stancupatrick1/spitalul-virtual/watch/hardware/kicad/drc_report.txt

** Drc report for spitalul_virtual_watch.kicad_pcb **
** Created on 2026-10-27 00:28:51 **

** Found 0 DRC violations **

** Found 0 unconnected pads **

** Found 0 Footprint errors **

** End of Report **
