stancupatrick1/spitalul-virtual/band/docs/img/band_back.png

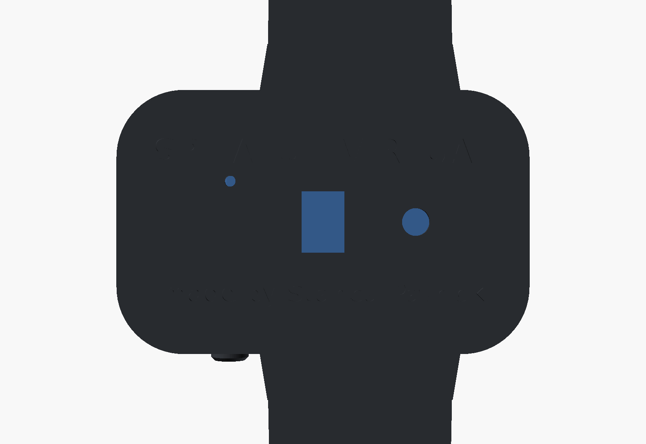
band/docs/img/band_back.png
