stancupatrick1/spitalul-virtual/band/docs/img/band_inside.png

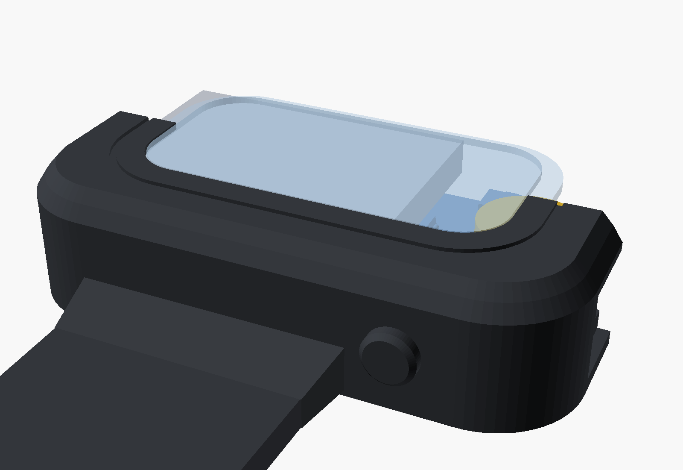
band/docs/img/band_inside.png
