stancupatrick1/spitalul-virtual/site/olimpiada.jpg

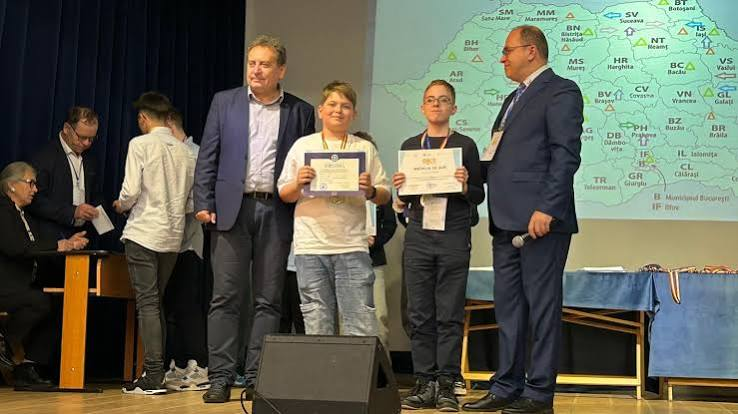
site/olimpiada.jpg
