stancupatrick1/spitalul-virtual/watch/docs/img/watch_bottom.png

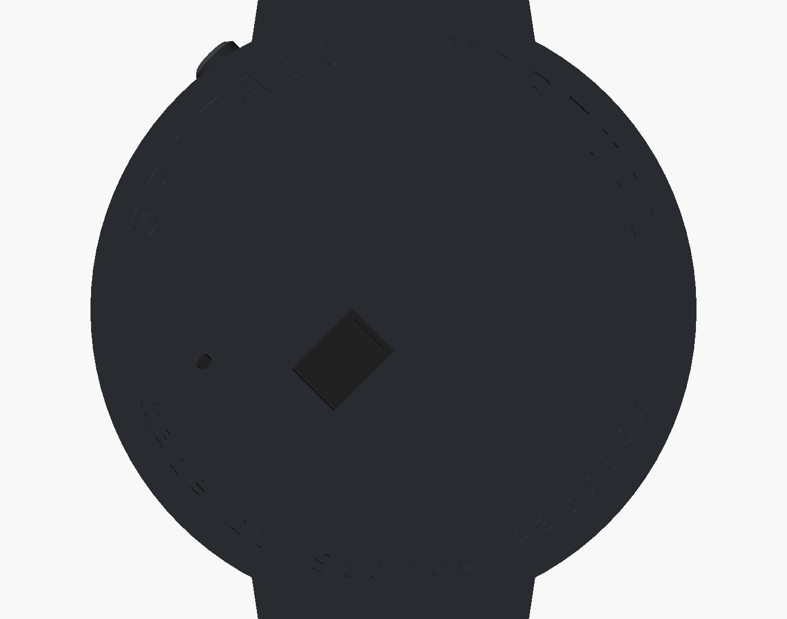
watch/docs/img/watch_bottom.png
