stancupatrick1/spitalul-virtual/band/hardware/jlcpcb/spitalul_virtual_band_BOM.csv

Comment | Designator | Footprint | LCSC Part #
1uF | C1,C8,C9 | C_0402_1005Metric | C52923
100nF | C3,C10,C12,C13,C15,C16 | C_0402_1005Metric | C1525
10uF | C2,C4,C5,C6,C7,C11,C14 | C_0603_1608Metric | C19702
1N4148WS | D1 | D_SOD-323 | C2128
Red LED | D2 | LED_0603_1608Metric | C2286
Green LED | D3 | LED_0603_1608Metric | C72043
USB-C 16P | J1 | USB_C_Receptacle_HRO_TYPE-C-31-M-12 | C165948
AO3400A | Q1 | SOT-23 | C20917
10k | R1,R10,R11,R12 | R_0402_1005Metric | C25744
100k | R8,R9,R13 | R_0402_1005Metric | C25741
1k | R5,R14 | R_0402_1005Metric | C11702
5.1k | R2,R3 | R_0402_1005Metric | C25905
4.7k | R4,R6,R7 | R_0402_1005Metric | C25900
EVQP7C01P | SW1 | SW_SPST_EVQP7C | C388883
ESP32-C3-WROOM-02-N4 | U1 | ESP32-C3-WROOM-02 | C2934560
MAX30102EFD+T | U2 | Maxim_OLGA-14_3.3x5.6mm_P0.8mm | C6454833
LIS3DHTR | U3 | LGA-16_3x3mm_P0.5mm_LayoutBorder3x5y | C15134
MCP73831T-2ACI/OT | U4 | SOT-23-5 | C424093
ME6211C33M5G-N | U5 | SOT-23-5 | C82942
XC6206P182MR | U6 | SOT-23 | C347373
TMP117AIDRVR | U7 | WSON-6-1EP_2x2mm_P0.65mm_EP1x1.6mm | C699536
