stancupatrick1/spitalul-virtual/band/mechanical/pcb_assembled.step

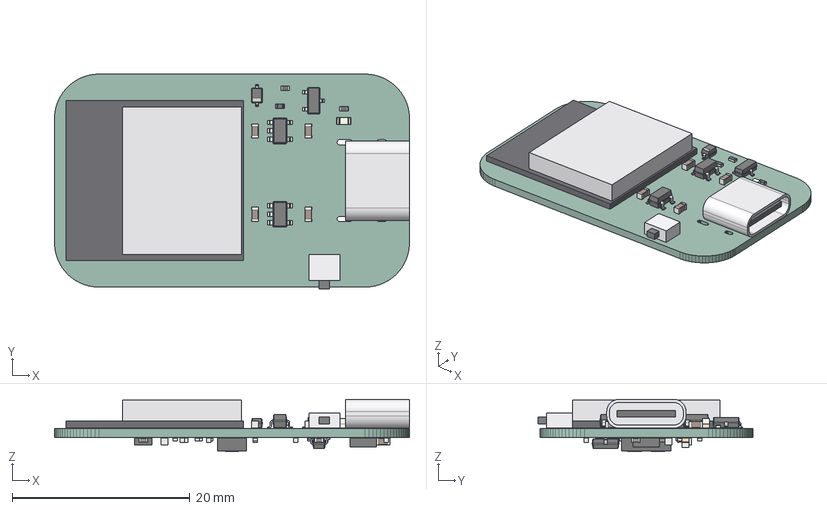
[picture p14: CAD file, 2026-11-08]
band/mechanical/pcb_assembled.step
40.0 x 24.2 x 5.91 mm
LED_0603_1608Metric x 2
SOT_23_5 x 2
R_0402_1005Metric x 14
D_SOD_323
C_0603_1608Metric x 7
6a490142-d207-11f1-81ee-f1fb133c2f88
6a516062-d207-11f1-81ee-f1fb133c2f88
SOT_23 x 2
6a4750ae-d207-11f1-81ee-f1fb133c2f88
C_0402_1005Metric x 9
WSON_6_1EP_2x2mm_P065mm_EP1x16mm
6a4ff8b2-d207-11f1-81ee-f1fb133c2f88
LGA_16_3x3mm_P05mm_LayoutBorder3x5y
spitalul_virtual_band PCB
