stancupatrick1/spitalul-virtual/watch/mechanical/pcb_assembled.step

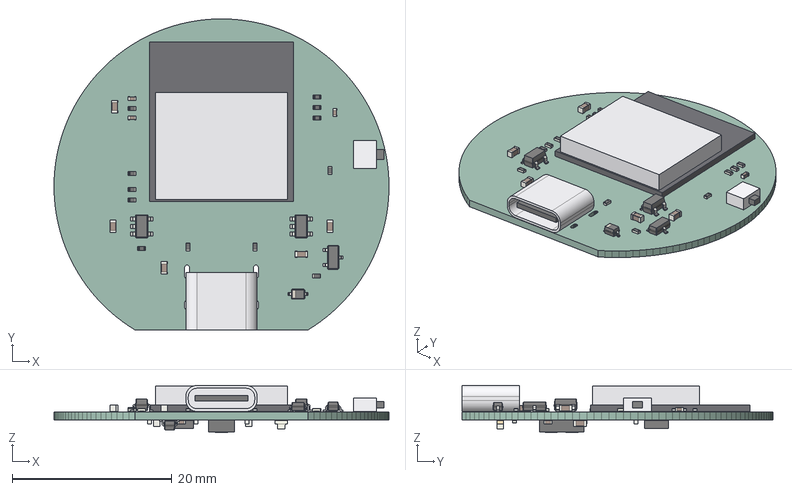
[picture p15: CAD file, 2026-11-08]
watch/mechanical/pcb_assembled.step
42.0 x 39.0 x 5.91 mm
R_0402_1005Metric x 13
C_0603_1608Metric x 7
D_SOD_323
C_0402_1005Metric x 8
7226c212-d18c-11f1-bdcd-9d31cddf0451
SOT_23_5 x 2
7233ba26-d18c-11f1-bdcd-9d31cddf0451
SOT_23 x 2
72246710-d18c-11f1-bdcd-9d31cddf0451
72318ba2-d18c-11f1-bdcd-9d31cddf0451
LED_0603_1608Metric
LGA_16_3x3mm_P05mm_LayoutBorder3x5y
spitalul_virtual_watch PCB
