stancupatrick1/spitalul-virtual/band/mechanical/stl/band_top_cap.stl

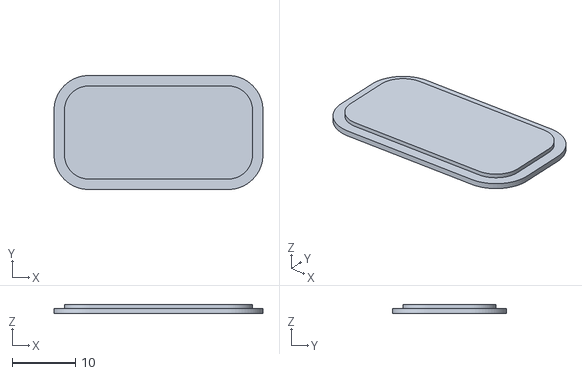
[picture p16: CAD file, 2026-11-08]
band/mechanical/stl/band_top_cap.stl
33.0 x 18.0 x 1.39
