stancupatrick1/spitalul-virtual/band/mechanical/stl/mold/mold_core.stl

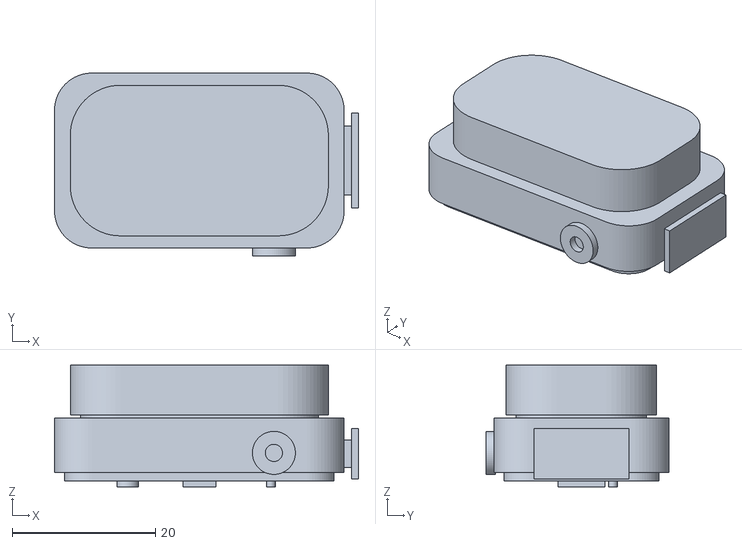
[picture p17: CAD file, 2026-11-08]
band/mechanical/stl/mold/mold_core.stl
42.4 x 25.5 x 17.0
