stancupatrick1/spitalul-virtual/watch/mechanical/stl/mold/mold_core.stl

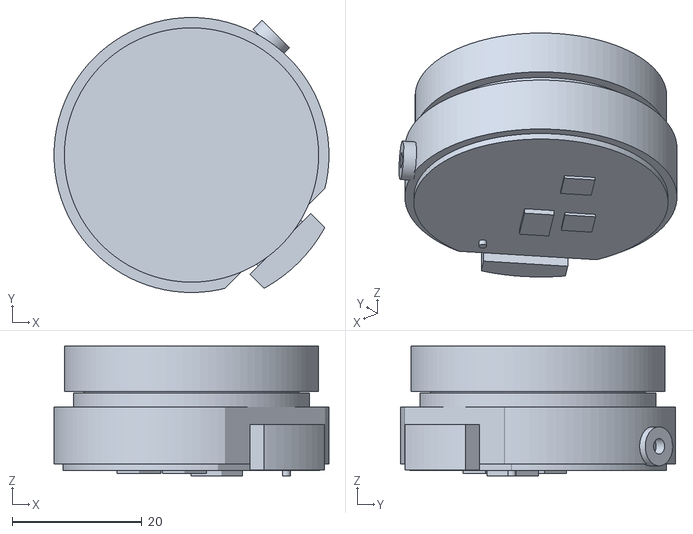
[picture p18: CAD file, 2026-11-08]
watch/mechanical/stl/mold/mold_core.stl
42.4 x 42.4 x 20.0
