stancupatrick1/spitalul-virtual/watch/mechanical/stl/strap_keeper_loop.stl

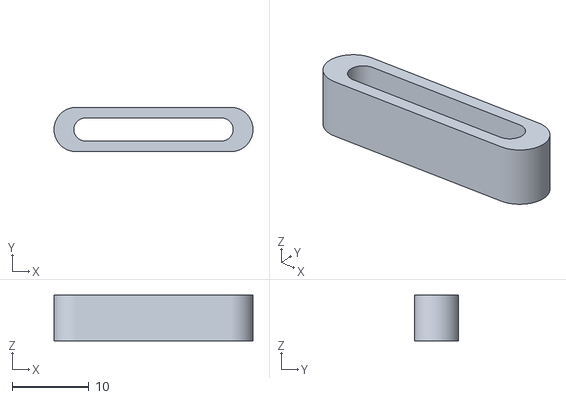
[picture p19: CAD file, 2026-11-08]
watch/mechanical/stl/strap_keeper_loop.stl
26.0 x 5.80 x 6.00
