stancupatrick1/spitalul-virtual/band/mechanical/stl/mold/mold_bottom.stl

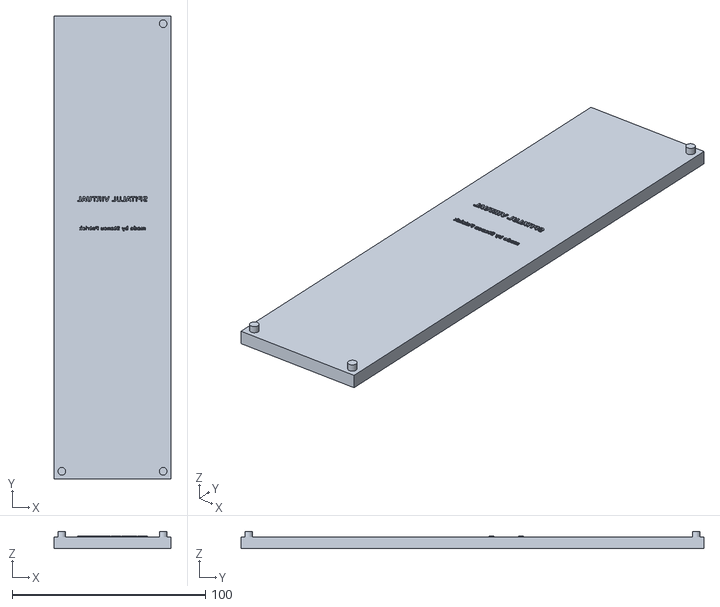
[picture p20: CAD file, 2026-11-08]
band/mechanical/stl/mold/mold_bottom.stl
60.4 x 239.4 x 9.00
