stancupatrick1/spitalul-virtual/watch/mechanical/stl/case_silicone_with_straps.stl

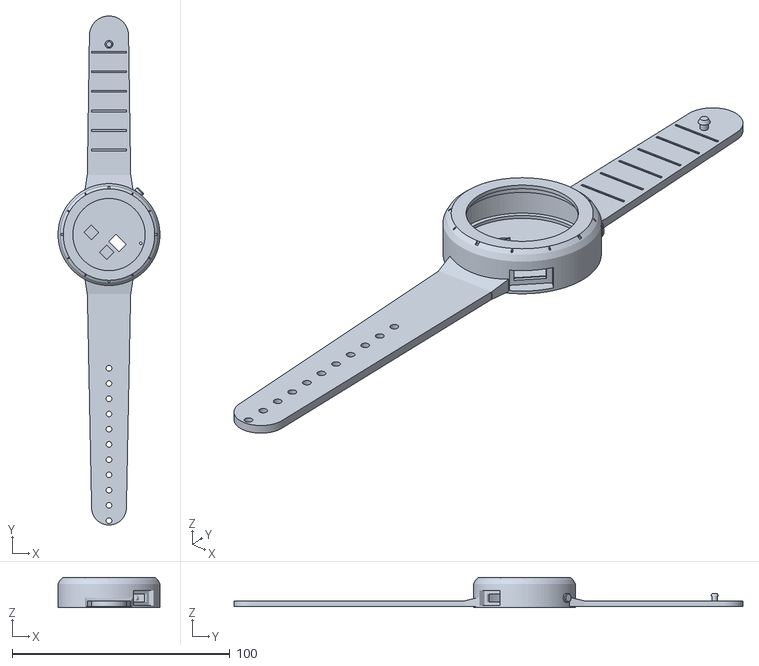
[picture p21: CAD file, 2026-11-08]
watch/mechanical/stl/case_silicone_with_straps.stl
46.8 x 233.8 x 14.0
