stancupatrick1/spitalul-virtual/watch/mechanical/stl/mold/mold_top.stl

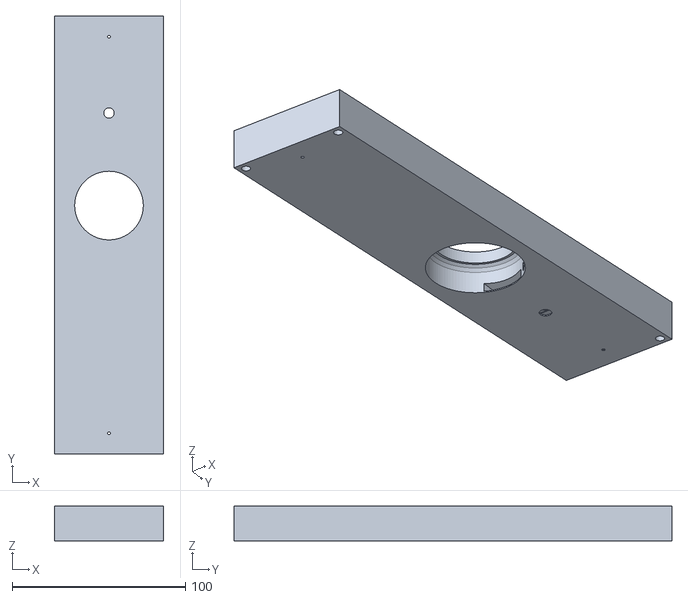
[picture p22: CAD file, 2026-11-08]
watch/mechanical/stl/mold/mold_top.stl
62.8 x 252.8 x 20.0
