stancupatrick1/spitalul-virtual/band/mechanical/stl/band_silicone_with_straps.stl

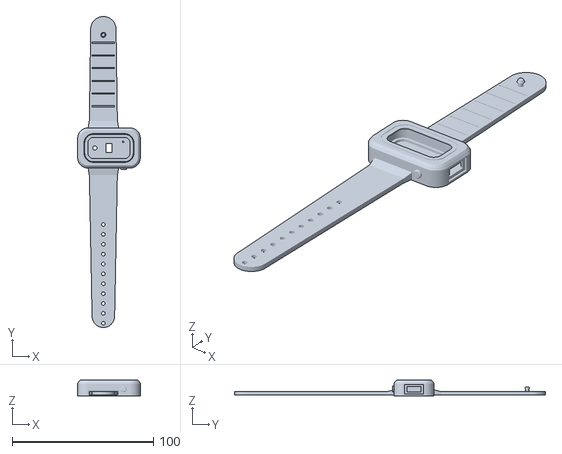
[picture p23: CAD file, 2026-11-08]
band/mechanical/stl/band_silicone_with_straps.stl
44.4 x 220.4 x 11.0
