stancupatrick1/spitalul-virtual/band/mechanical/stl/mold/mold_top.stl

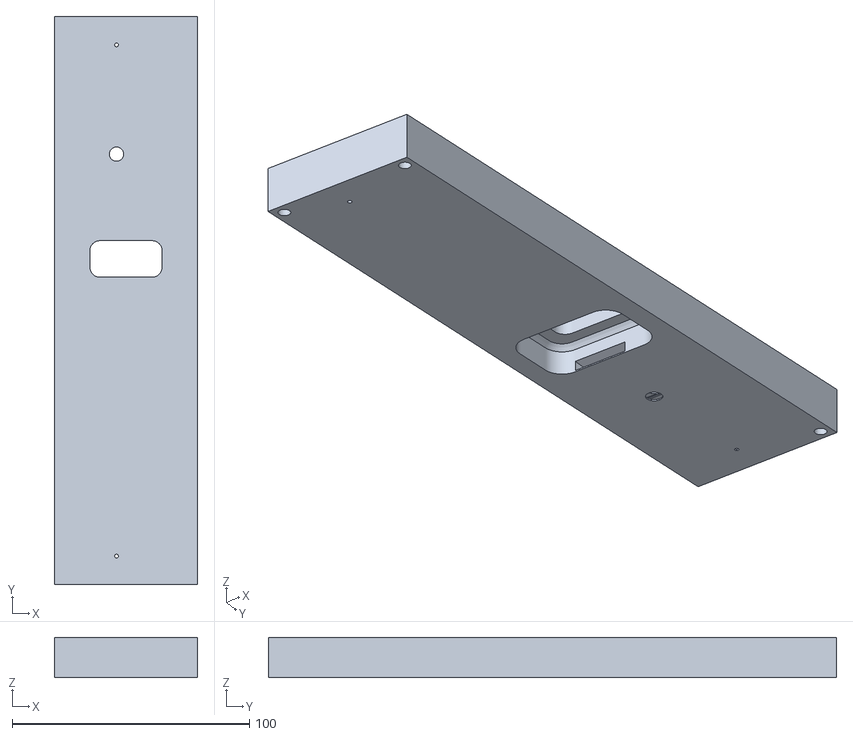
[picture p24: CAD file, 2026-11-08]
band/mechanical/stl/mold/mold_top.stl
60.4 x 239.4 x 17.0
