stancupatrick1/spitalul-virtual/watch/mechanical/stl/mold/mold_bottom.stl

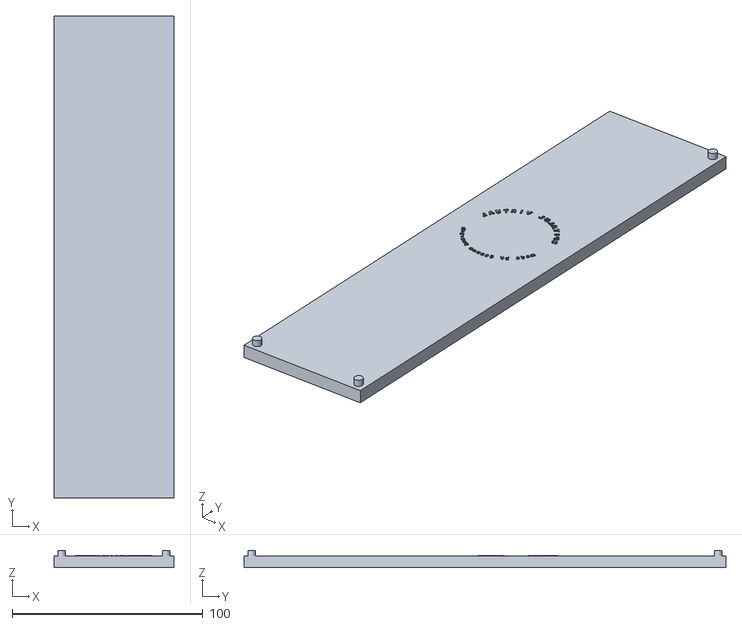
[picture p25: CAD file, 2026-11-08]
watch/mechanical/stl/mold/mold_bottom.stl
62.8 x 252.8 x 9.00
