stancupatrick1/spitalul-virtual/(list of files, cad)

Other CAD files:
band/mechanical/stl/band_strap_keeper.stl
band/mechanical/stl/pcb_assembled.stl
watch/mechanical/stl/pcb_assembled.stl
