stancupatrick1/spitalul-virtual/band/docs/schematic.pdf

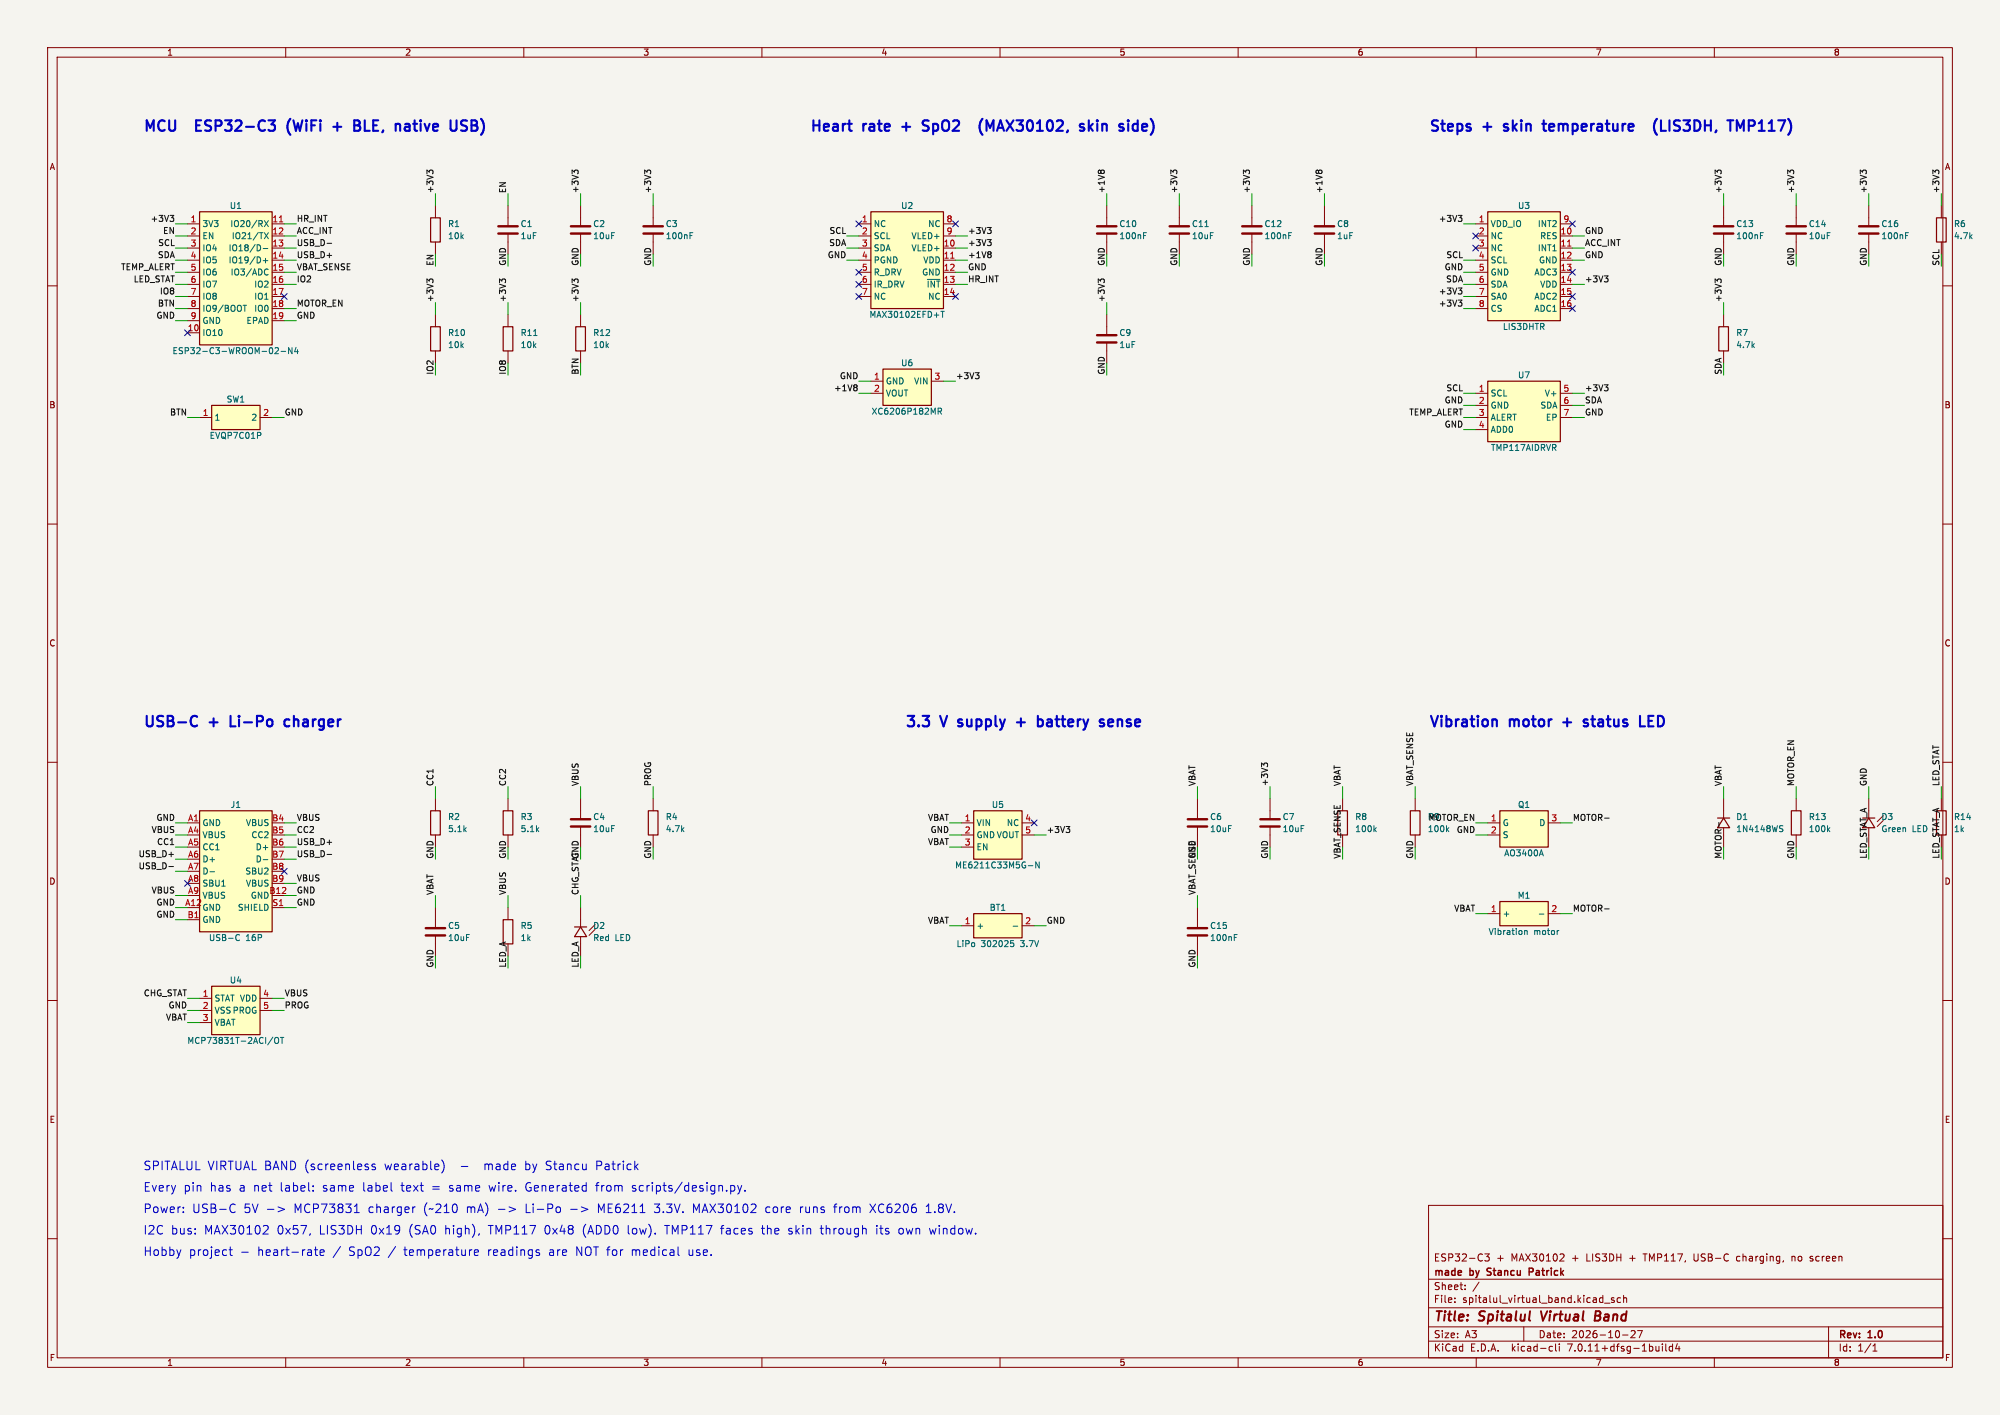
[picture p27: page 1]

INT1 11 GND 12 ADC3 13 VDD 14 ADC2 15 ADC1 16 NC 2 NC 3 SCL 4 GND 5 SDA 6 SA0 7 CS 8

Every pin has a net label: same label text = same wire. Generated from scripts/design.py.
I2C bus: MAX30102 0x57, LIS3DH 0x19 (SA0 high), TMP117 0x48 (ADD0 low). TMP117 faces the skin through its own window.

Id: 1/1 Title: Spitalul Virtual Band
