stancupatrick1/spitalul-virtual/watch/docs/schematic.pdf

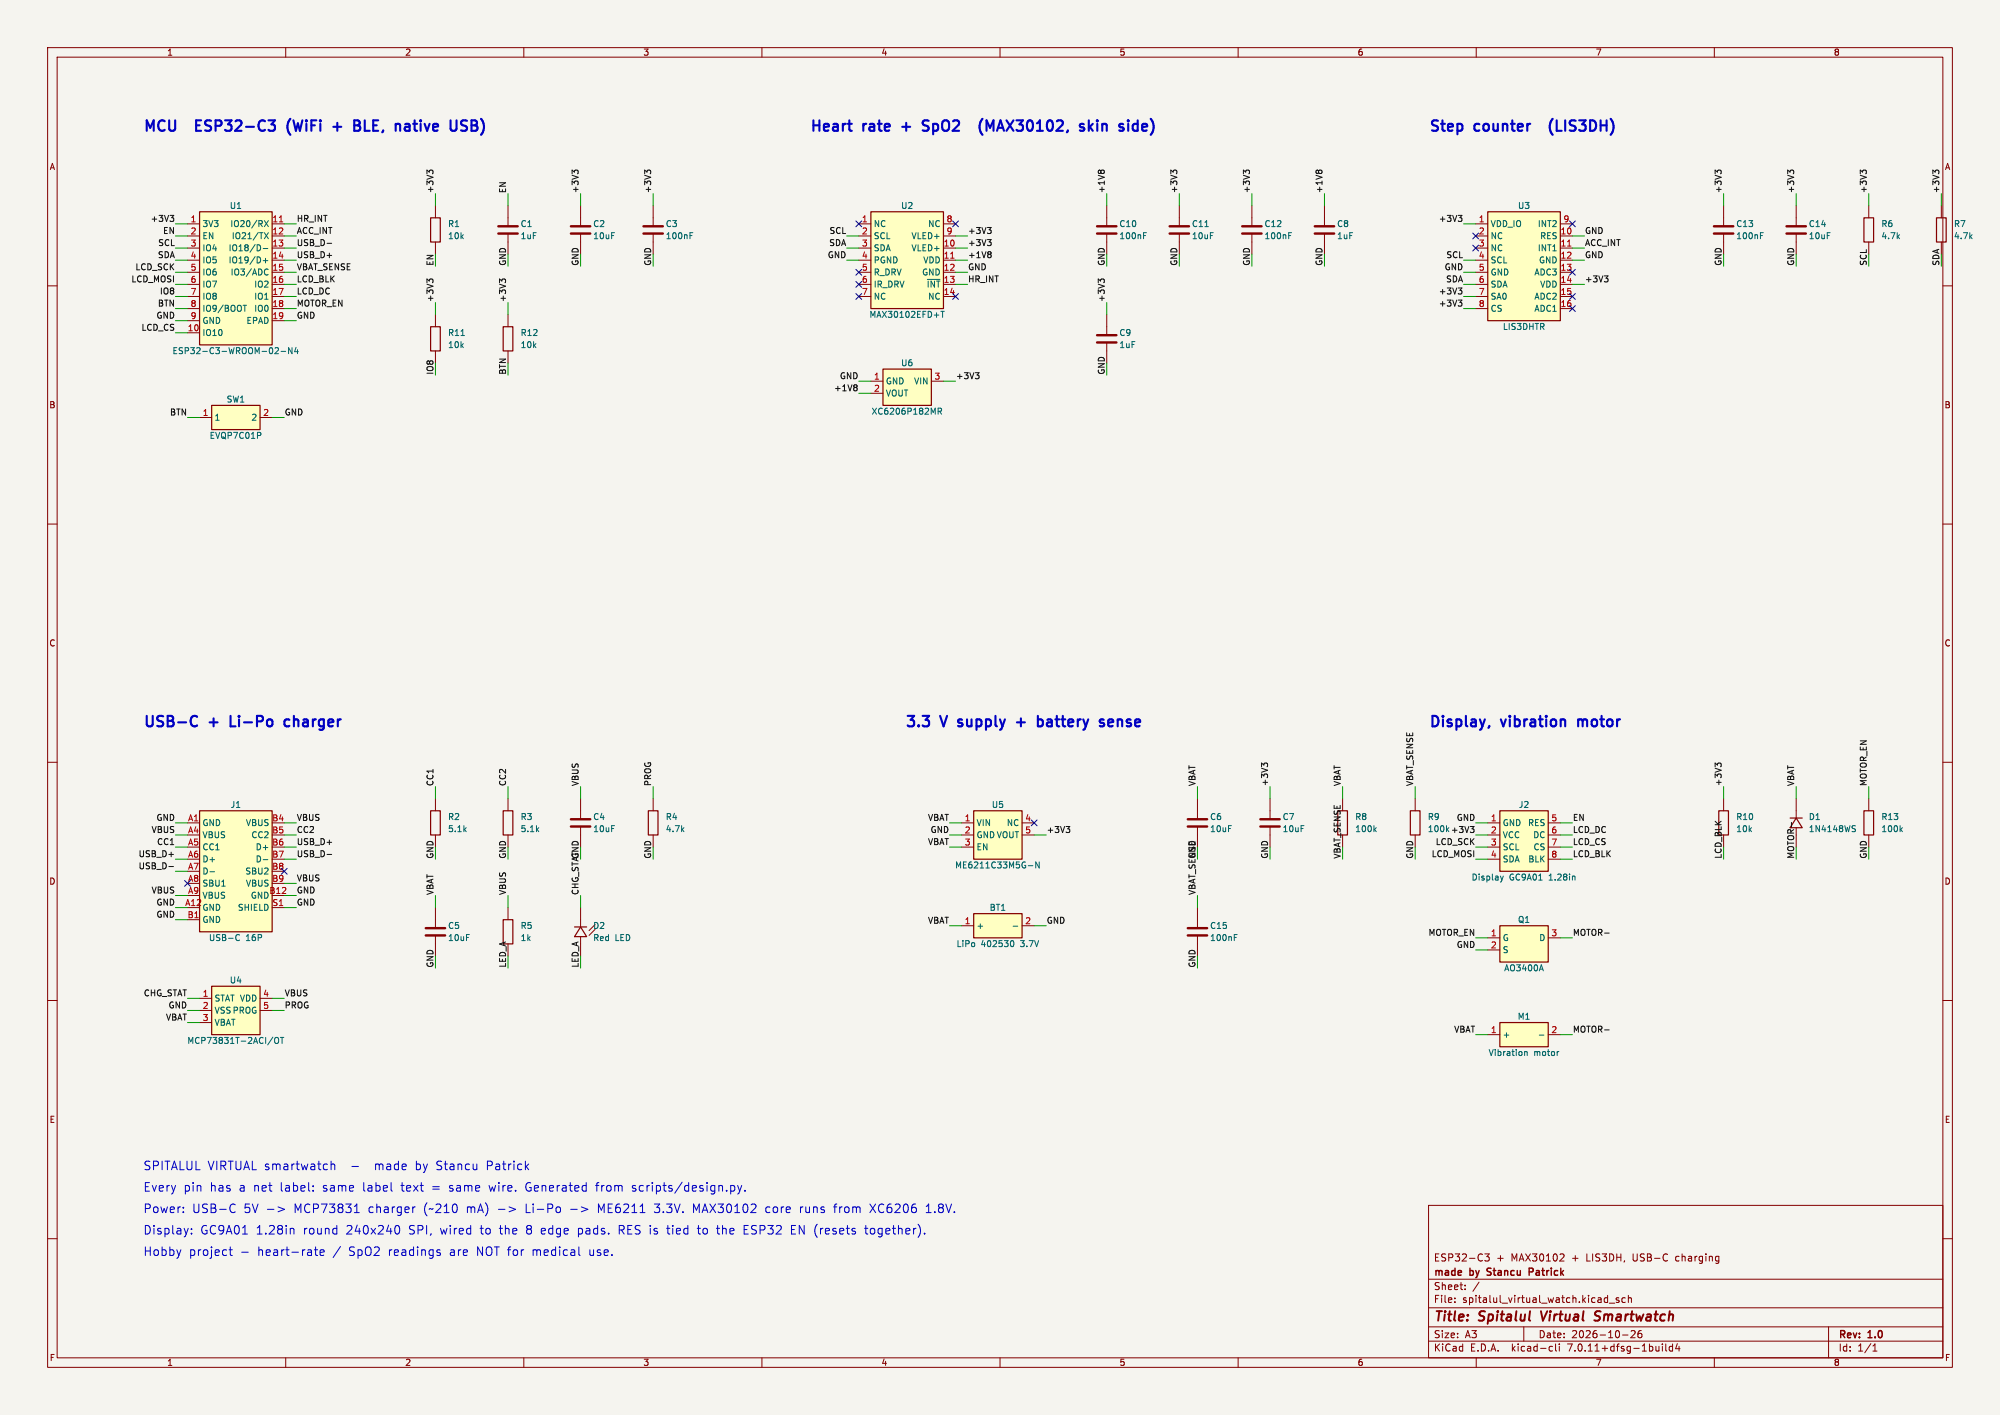
[picture p28: page 1]

VBAT VBAT PROG VBUS

Every pin has a net label: same label text = same wire. Generated from scripts/design.py.

Id: 1/1 Title: Spitalul Virtual Smartwatch
