stancupatrick1/spitalul-virtual/band/docs/pcb_bottom_layer.pdf

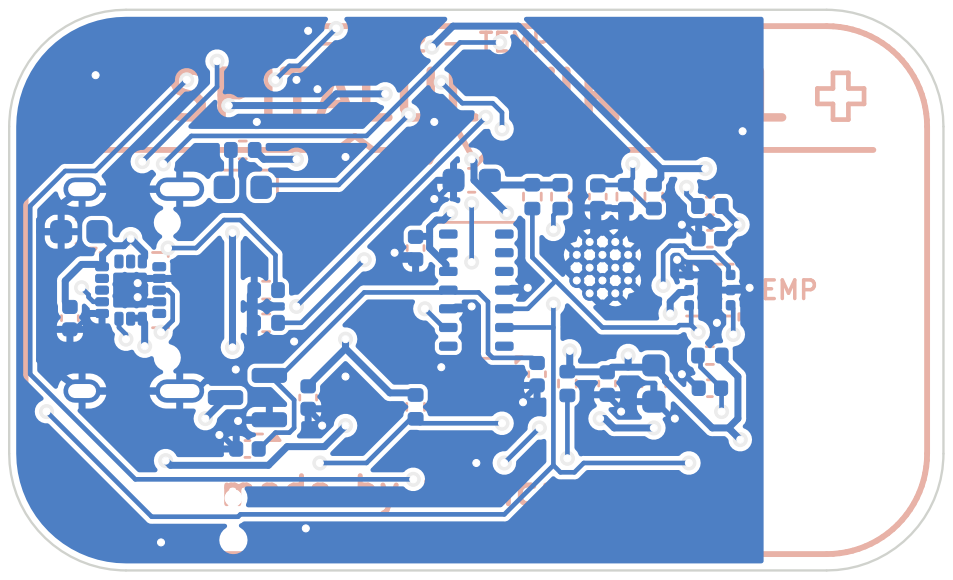
[picture p29: page 1]

TEMP HR - SpO2 - TEMP - STEPS
