stancupatrick1/spitalul-virtual/band/docs/pcb_top_layer.pdf

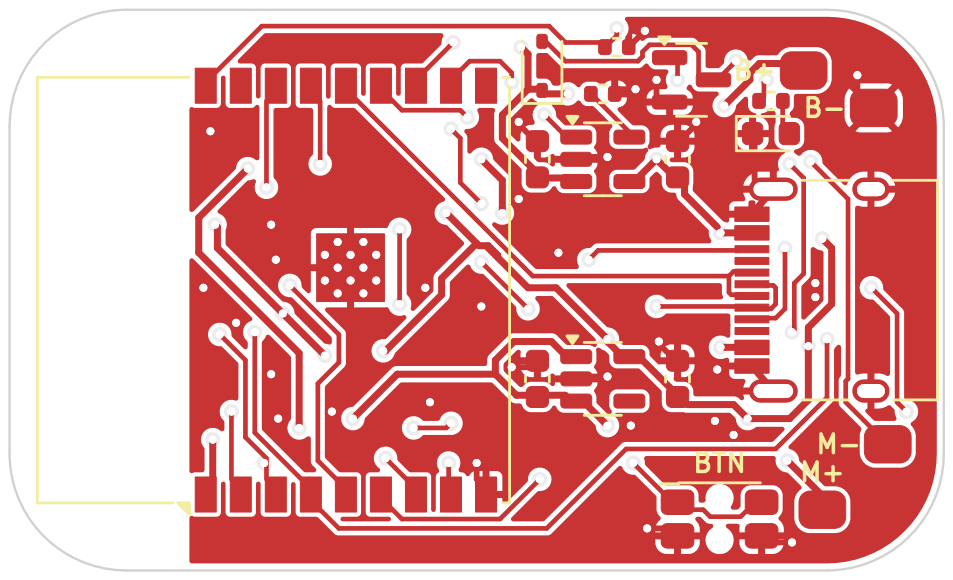
[picture p30: page 1]
