stancupatrick1/spitalul-virtual/watch/docs/pcb_bottom_layer.pdf

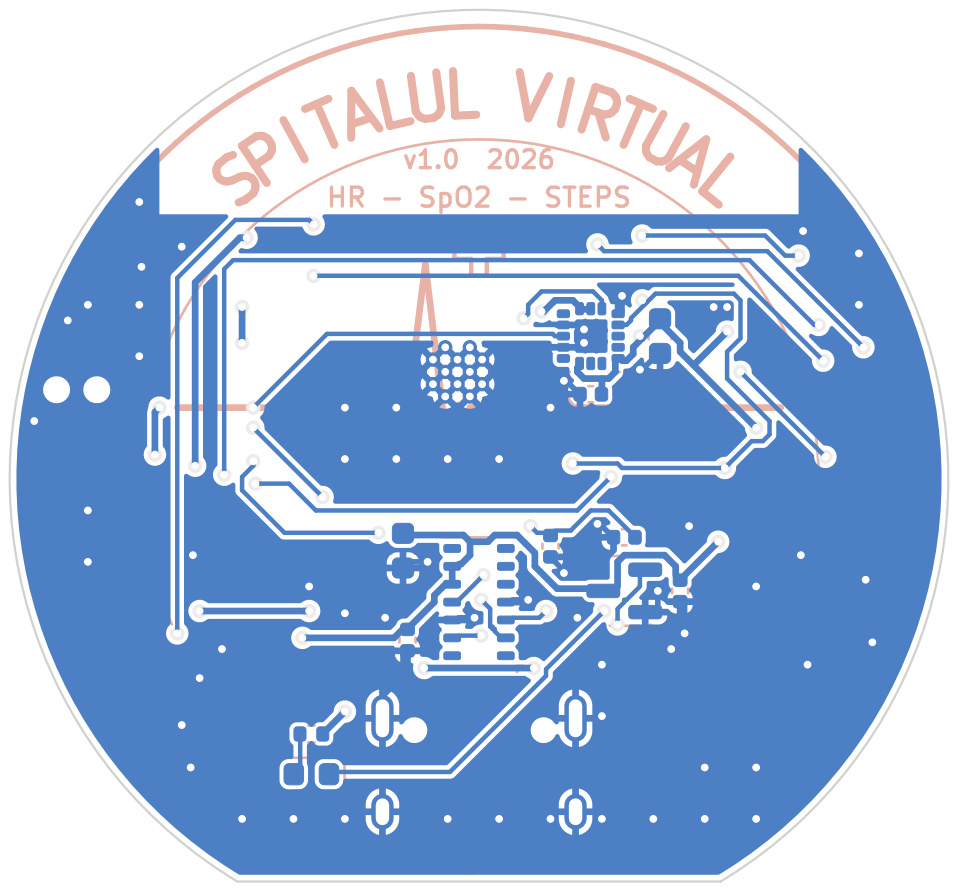
[picture p31: page 1]
