stancupatrick1/spitalul-virtual/watch/docs/pcb_top_layer.pdf

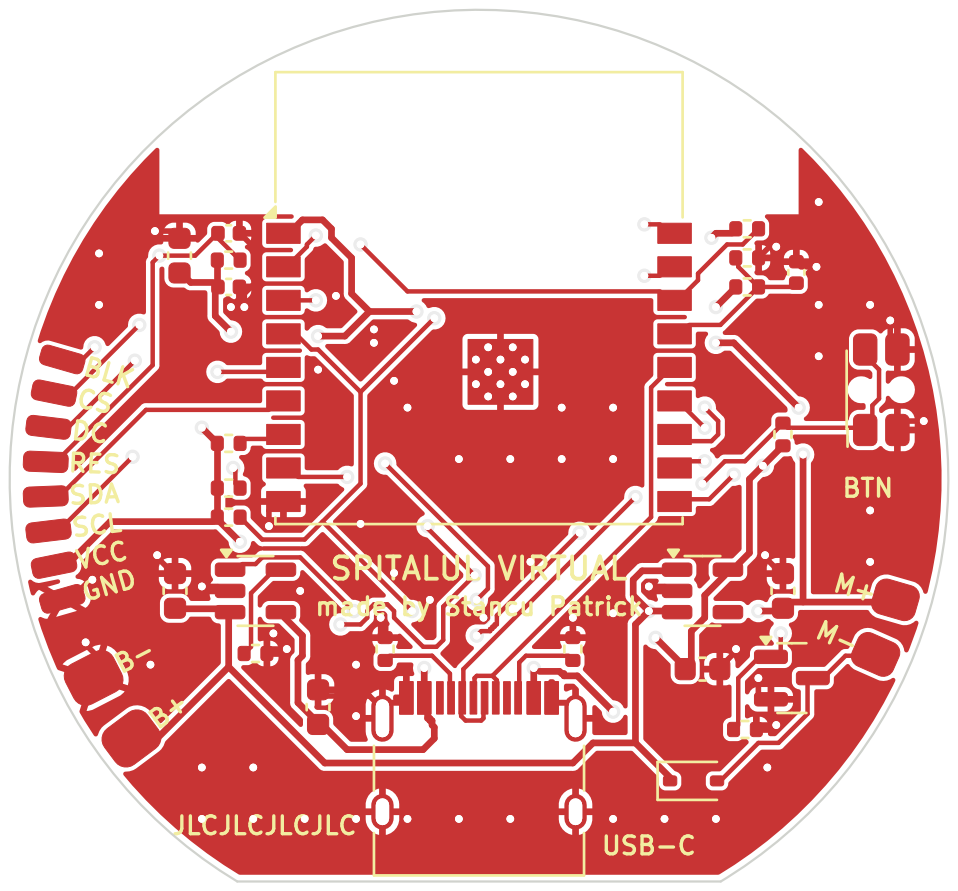
[picture p32: page 1]
