stancupatrick1/spitalul-virtual/band/hardware/kicad/spitalul_virtual_band.kicad_pcb

## KiCad design band/hardware/kicad/spitalul_virtual_band.kicad_pcb (2026-11-08)

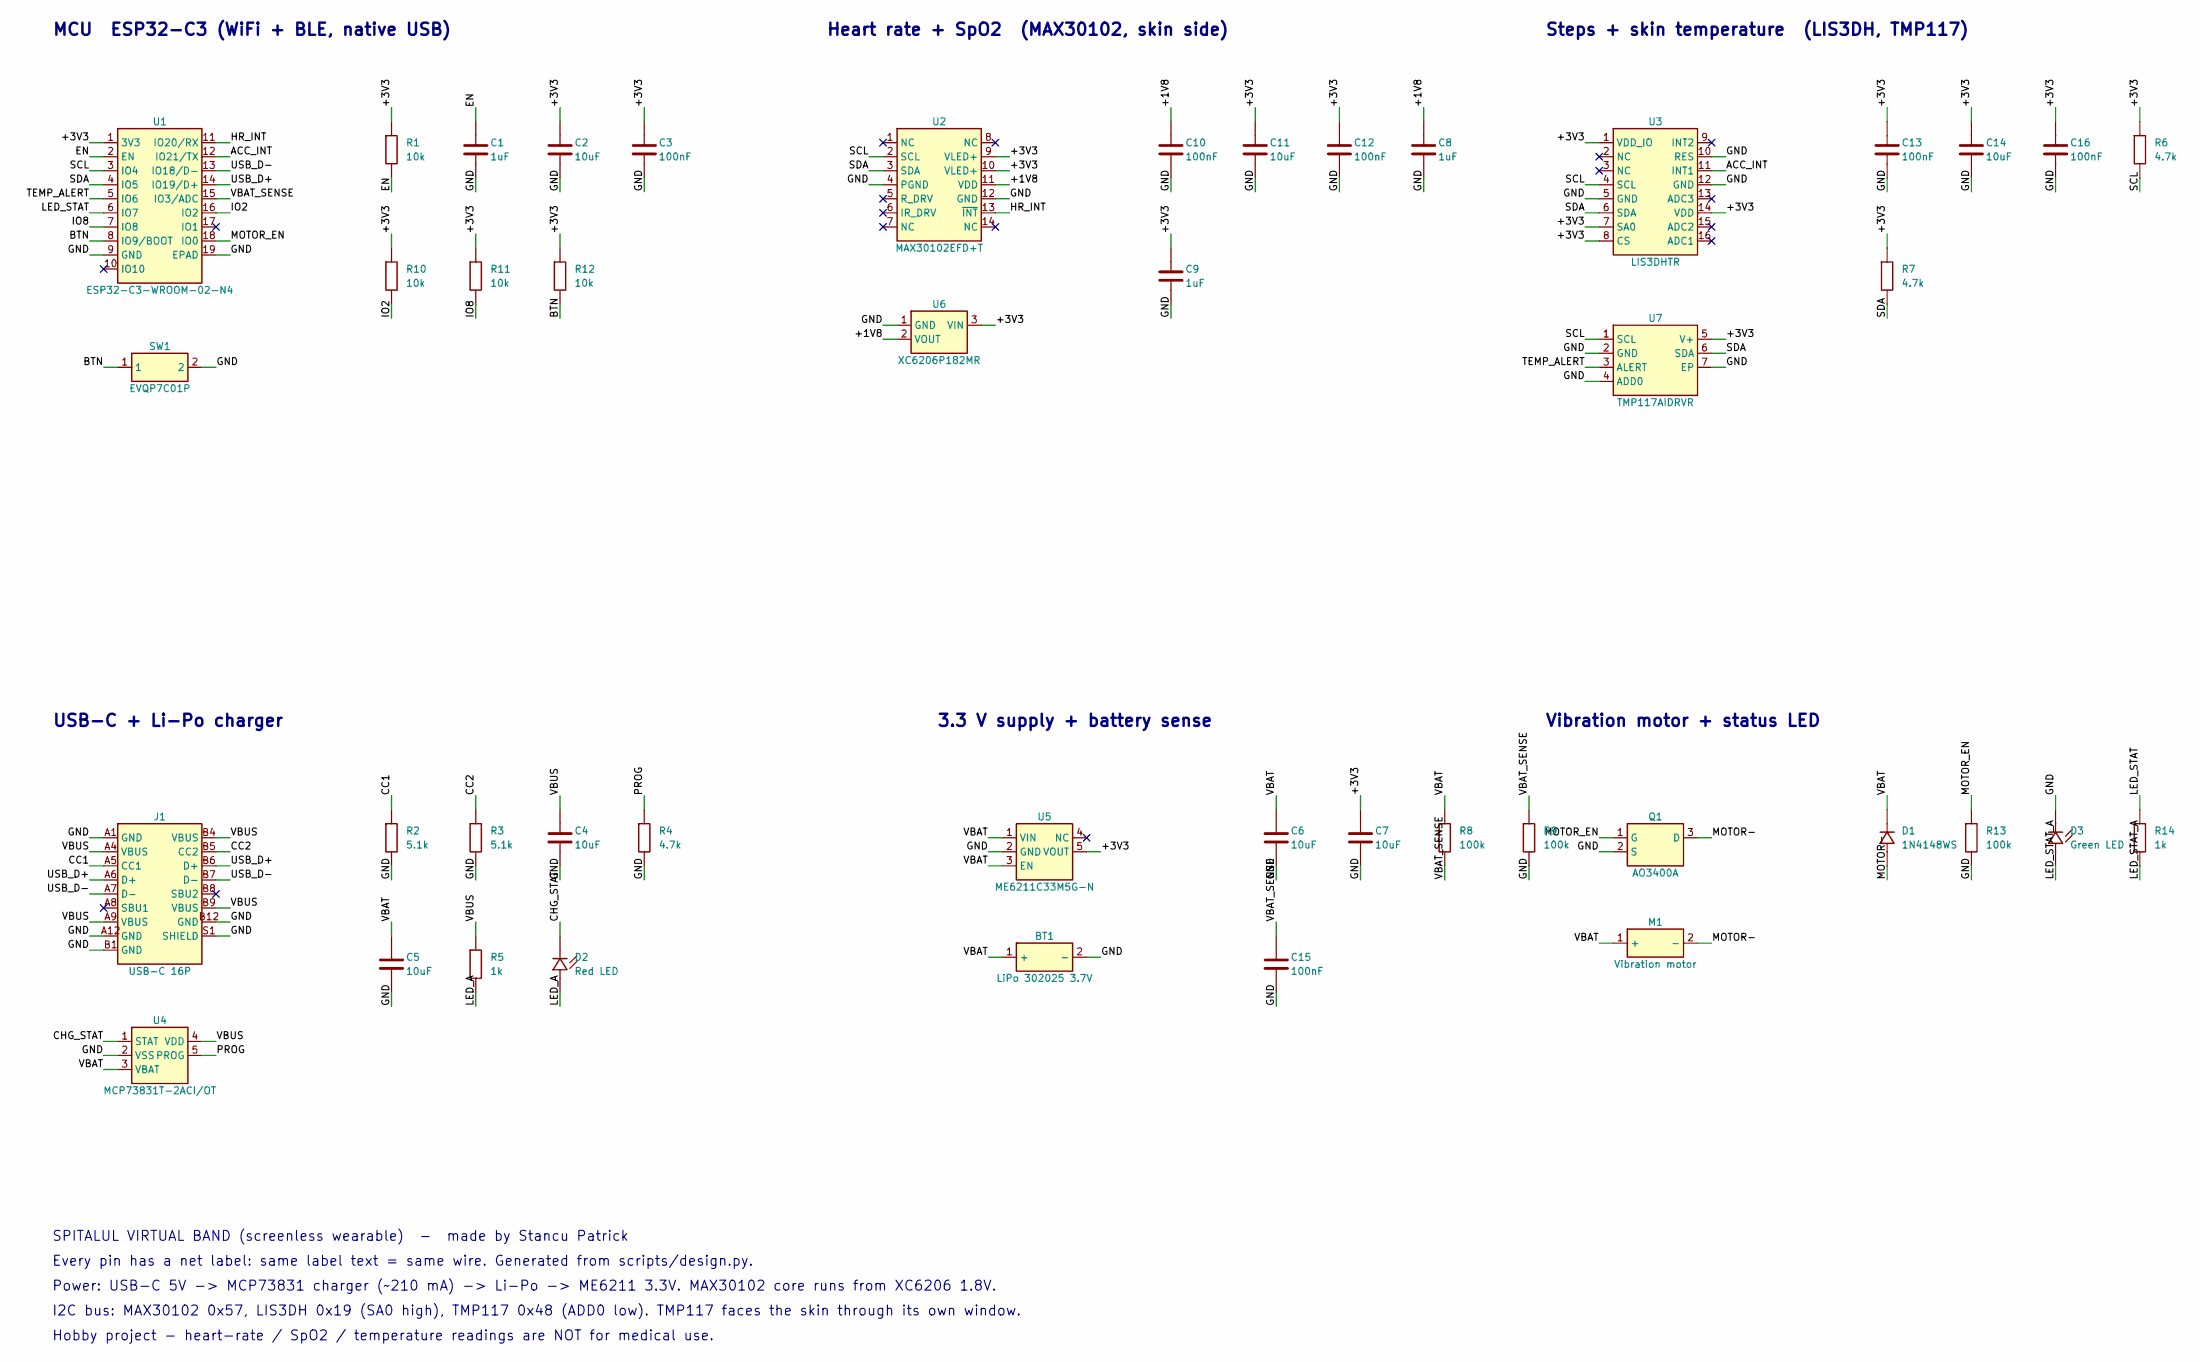
[picture p33: schematic spitalul_virtual_band.kicad_sch, Spitalul Virtual Band]

Parts:
BT1: LiPo 302025 3.7V; BatteryPads
C1, C8, C9: 1uF; C_0402_1005Metric; LCSC C52923
C2, C4, C5, C6, C7, C11, C14: 10uF; C_0603_1608Metric; LCSC C19702
C3, C10, C12, C13, C15, C16: 100nF; C_0402_1005Metric; LCSC C1525
D1: 1N4148WS; D_SOD-323; LCSC C2128
D2: Red LED; LED_0603_1608Metric; LCSC C2286
D3: Green LED; LED_0603_1608Metric; LCSC C72043
J1: USB-C 16P; USB_C_Receptacle_HRO_TYPE-C-31-M-12; LCSC C165948
M1: Vibration motor; MotorPads
Q1: AO3400A; SOT-23; LCSC C20917
R1, R10, R11, R12: 10k; R_0402_1005Metric; LCSC C25744
R2, R3: 5.1k; R_0402_1005Metric; LCSC C25905
R4, R6, R7: 4.7k; R_0402_1005Metric; LCSC C25900
R5, R14: 1k; R_0402_1005Metric; LCSC C11702
R8, R9, R13: 100k; R_0402_1005Metric; LCSC C25741
SW1: EVQP7C01P; SW_SPST_EVQP7C; LCSC C388883
U1: ESP32-C3-WROOM-02-N4; ESP32-C3-WROOM-02; LCSC C2934560
U2: MAX30102EFD+T; Maxim_OLGA-14_3.3x5.6mm_P0.8mm; LCSC C6454833
U3: LIS3DHTR; LGA-16_3x3mm_P0.5mm_LayoutBorder3x5y; LCSC C15134
U4: MCP73831T-2ACI/OT; SOT-23-5; LCSC C424093
U5: ME6211C33M5G-N; SOT-23-5; LCSC C82942
U6: XC6206P182MR; SOT-23; LCSC C347373
U7: TMP117AIDRVR; WSON-6-1EP_2x2mm_P0.65mm_EP1x1.6mm; LCSC C699536

Connections:
+1V8: C8.1, C10.1, U2.11 (VDD), U6.2 (VOUT)
+3V3: C2.1, C3.1, C7.1, C9.1, C11.1, C12.1, C13.1, C14.1, C16.1, R1.1, R6.1, R7.1, R10.1, R11.1, R12.1, U1.1 (3V3), U2.9 (VLED+), U2.10 (VLED+), U3.1 (VDD_IO), U3.7 (SA0), U3.8 (CS), U3.14 (VDD), U5.5 (VOUT), U6.3 (VIN), U7.5 (V+)
ACC_INT: U1.12 (IO21/TX), U3.11 (INT1)
BTN: R12.2, SW1.1, U1.8 (IO9/BOOT)
CC1: J1.A5 (CC1), R2.1
CC2: J1.B5 (CC2), R3.1
CHG_STAT: D2.1, U4.1 (STAT)
EN: C1.1, R1.2, U1.2 (EN)
GND: BT1.2 (-), C1.2, C2.2, C3.2, C4.2, C5.2, C6.2, C7.2, C8.2, C9.2, C10.2, C11.2, C12.2, C13.2, C14.2, C15.2, C16.2, D3.1, J1.A1 (GND), J1.A12 (GND), J1.B1 (GND), J1.B12 (GND), J1.S1 (SHIELD), Q1.2 (S), R2.2, R3.2, R4.2, R9.2, R13.2, SW1.2, U1.9 (GND), U1.19 (EPAD), U2.4 (PGND), U2.12 (GND), U3.5 (GND), U3.10 (RES), U3.12 (GND), U4.2 (VSS), U5.2 (GND), U6.1 (GND), U7.2 (GND), U7.4 (ADD0), U7.7 (EP)
HR_INT: U1.11 (IO20/RX), U2.13 (~INT)
IO2: R10.2, U1.16 (IO2)
IO8: R11.2, U1.7 (IO8)
LED_A: D2.2, R5.2
LED_STAT: R14.1, U1.6 (IO7)
LED_STAT_A: D3.2, R14.2
MOTOR-: D1.2, M1.2 (-), Q1.3 (D)
MOTOR_EN: Q1.1 (G), R13.1, U1.18 (IO0)
PROG: R4.1, U4.5 (PROG)
SCL: R6.2, U1.3 (IO4), U2.2 (SCL), U3.4 (SCL), U7.1 (SCL)
SDA: R7.2, U1.4 (IO5), U2.3 (SDA), U3.6 (SDA), U7.6 (SDA)
TEMP_ALERT: U1.5 (IO6), U7.3 (ALERT)
USB_D+: J1.A6 (D+), J1.B6 (D+), U1.14 (IO19/D+)
USB_D-: J1.A7 (D-), J1.B7 (D-), U1.13 (IO18/D-)
VBAT: BT1.1 (+), C5.1, C6.1, D1.1, M1.1 (+), R8.1, U4.3 (VBAT), U5.1 (VIN), U5.3 (EN)
VBAT_SENSE: C15.1, R8.2, R9.1, U1.15 (IO3/ADC)
VBUS: C4.1, J1.A4 (VBUS), J1.A9 (VBUS), J1.B4 (VBUS), J1.B9 (VBUS), R5.1, U4.4 (VDD)

Notes on the sheet:
MCU ESP32-C3 (WiFi + BLE, native USB)
Heart rate + SpO2 (MAX30102, skin side)
Steps + skin temperature (LIS3DH, TMP117)
USB-C + Li-Po charger
3.3 V supply + battery sense
Vibration motor + status LED
SPITALUL VIRTUAL BAND (screenless wearable) - made by Stancu Patrick
Every pin has a net label: same label text = same wire. Generated from scripts/design.py.
Power: USB-C 5V -> MCP73831 charger (~210 mA) -> Li-Po -> ME6211 3.3V. MAX30102 core runs from XC6206 1.8V.
I2C bus: MAX30102 0x57, LIS3DH 0x19 (SA0 high), TMP117 0x48 (ADD0 low). TMP117 faces the skin through its own window.
Hobby project - heart-rate / SpO2 / temperature readings are NOT for medical use.

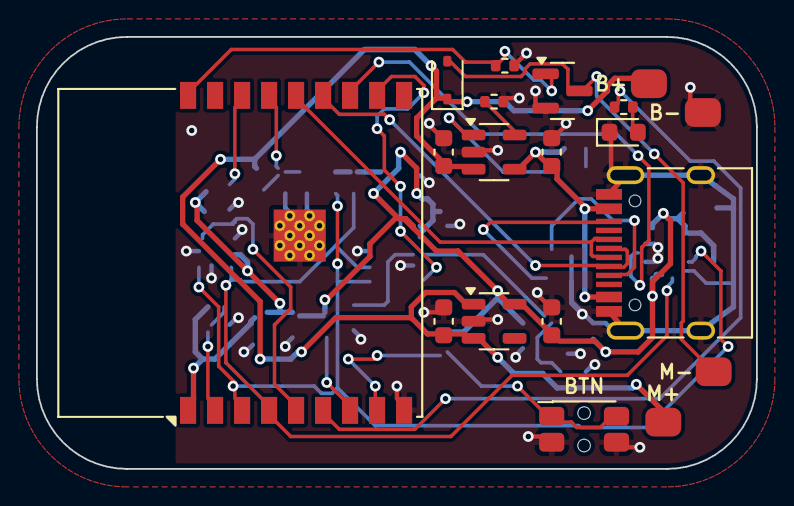
[picture p34: board spitalul_virtual_band.kicad_pcb from above]

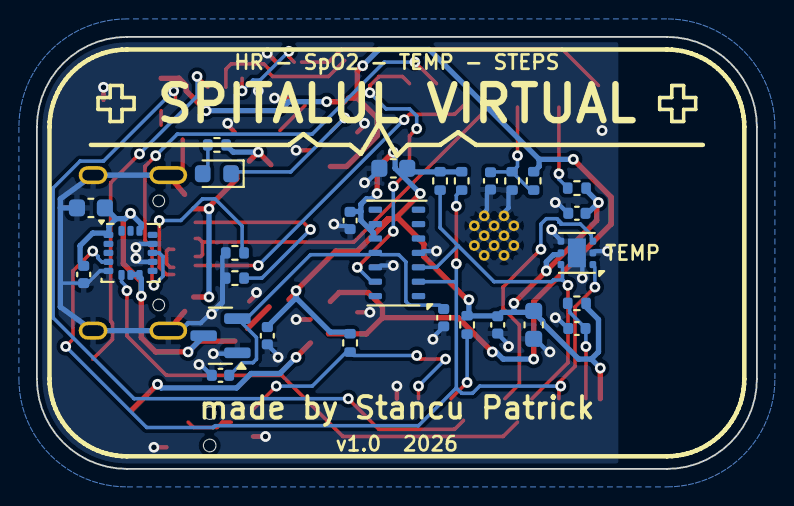
[picture p35: board spitalul_virtual_band.kicad_pcb from below]

Board: 2 copper layers, 40.0 x 24.0 mm, 45 parts (28 on the bottom side), 26 nets.
