stancupatrick1/spitalul-virtual/(commit log)

2026-11-08 Spitalul Virtual: open-source health smartwatch and band
    Watch and band: KiCad PCBs, JLCPCB files, silicone cases and molds,
    ESP32-C3 firmware and a Web Bluetooth app.
    [assembly.scad, band.scad, band_silicone_with_straps.stl, band_strap_keeper.stl, band_top_cap.stl, case.scad, case_silicone_with_straps.stl, mold_bottom.stl]
2026-11-08 Add the Spitalul Virtual website with sign-up form
    ECG-paper landing page (Romanian): devices, what it measures, how it
    works, about the author, and a sign-up form that saves to Supabase.
2026-11-08 Live panel: support Colmi smart rings and standard BLE heart-rate devices
    The panel now detects the device after connecting: Spitalul Virtual band,
    Colmi R0x/R1x rings (live heart rate, SpO2 on demand, steps, battery,
    find-my-ring) or any device with the standard Heart Rate service.
    Unknown devices get a clear 'not compatible' message.
2026-11-08 Live panel: show-all-devices option for rings with other Bluetooth names
2026-11-10 Band: all-day history + Spitalul Virtual phone app (Apple Health / Health Connect)
    - band firmware v2: one record per minute in flash (ring of 8 x 96 KB, ~40-45 days),
    UTC clock + time zone, sync=/info/clear commands, history characteristic 5b7e0004
    - companion/: Flutter app for Android + iPhone that downloads the history over BLE
    and writes heart rate, SpO2, steps (and skin temperature on Android) to the
    health store, where the Spitalul Virtual platform imports them through ROOK
    - GitHub Actions: builds firmware, APK and an unsigned iOS build; publishes downloads
    - web panel sends UTC time + tz
2026-11-13 Website: GitHub profile picture for Patrick, rename his button
